AhmedAdelKhalilHamza/NEON_2x1M/IDC_8Pin.png

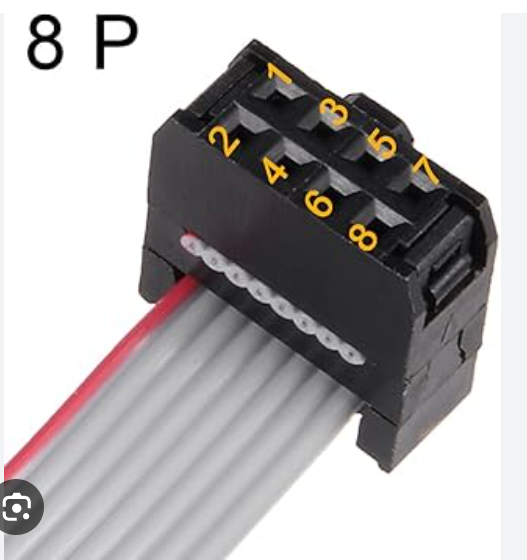
IDC_8Pin.png
