AhmedAdelKhalilHamza/NEON_2x1M/tutankhamon.png

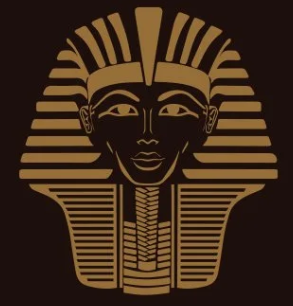
tutankhamon.png
