AhmedAdelKhalilHamza/NEON_2x1M/buck_converter_XL1509-3.3E1.png

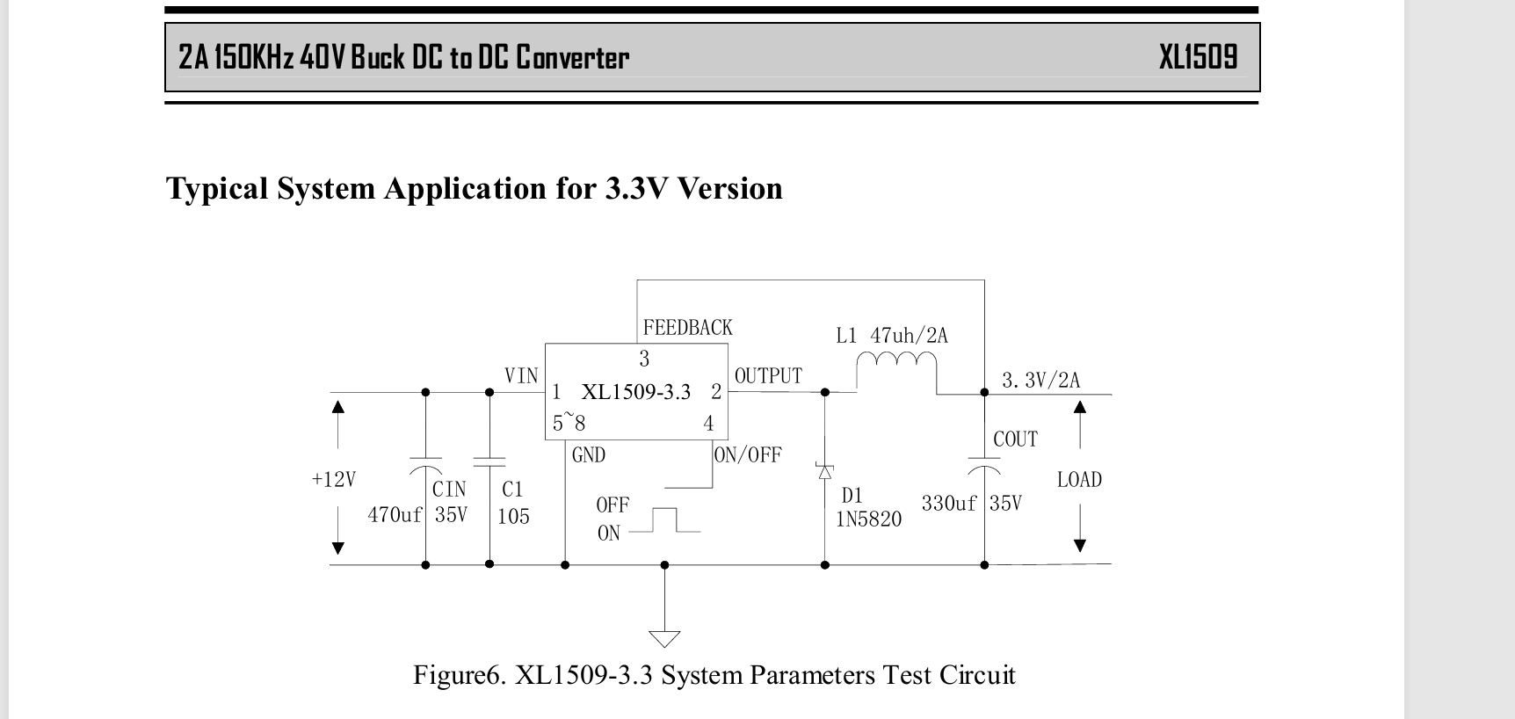
buck_converter_XL1509-3.3E1.png
