AhmedAdelKhalilHamza/NEON_2x1M/Neon_2x1M_12V/components_checklist_Neon_2x1M_12V.xlsx

Reference | Qty | Value | DNP | Exclude from BOM | Exclude from Board | Footprint | purchased components | link
C1 | 1 | 1 uF |  |  |  | Capacitor_SMD:C_1206_3216Metric | done | https://uge-one.com/product/smd-chip-capacitor-size-1206-1uf/
C2 | 1 | 470uF 35V |  |  |  | Capacitor_THT:CP_Radial_D10.0mm_P5.00mm |  | https://www.ram-e-shop.com/ar/shop/c-470u50v-capacitor-mkthf-kymyyy-470uf-mykrw-frd-50v-fwlt-6096
C3 | 1 | 330uF 50V |  |  |  | Capacitor_SMD:CP_Elec_10x10.5 | done | https://uge-one.com/product/smd-aluminum-electrolytic-capacitor-330uf-50v-1010-5-mm/
D1 | 1 | 1N5822 |  |  |  | Diode_SMD:D_SMA | done | https://uge-one.com/product/smd-schottky-diode-3a-40v-1n5822-ss34-sma/
D5 | 1 | Blue LED |  |  |  | LED_SMD:LED_1206_3216Metric_Pad1.42x1.75mm_HandSolder | done | https://makerselectronics.com/product/smd-led-blue-1206/
D9 | 1 | Red Power LED |  |  |  | LED_SMD:LED_1206_3216Metric_Pad1.42x1.75mm_HandSolder | done | https://makerselectronics.com/product/smd-led-red-1206/
D11 | 1 | LED_BGAR |  |  |  | LED_THT:LED_D5.0mm-4_RGB | done | https://makerselectronics.com/product/rgb-diffused-led-common-anode-5mm/
J2,J4,J5 | 3 | Barrel_Jack_MountingPin |  |  |  | Connector_BarrelJack:BarrelJack_Horizontal | done
J6 | 1 | Conn_01x03_Pin |  |  |  | Connector_PinHeader_2.54mm:PinHeader_1x03_P2.54mm_Vertical | done | https://microohm-eg.com/product/jst-3-pin-90-degree-male-connector/
L1 | 1 | 47uH / 2A |  |  |  | CD43_Inductor:CD43 | done | https://uge-one.com/product/smd-power-inductor-470uh-4-5x4x3-2mm-cd43/
Q1,Q2 | 2 | IRLML2502TRPBF |  |  |  | custom_SOT23:custom_SOT23 | 7 | https://uge-one.com/product/smd-irlml2502trpbf-sot-23-mosfet/
Q3 | 1 | Si2302DS |  |  |  | custom_SOT23:custom_SOT23 | 8 | https://uge-one.com/product/si2302ds-sot23-general-purpose-n-channel-mosfet-smd-transistor-sot-23/
Q4,Q5 | 2 | Si2302DS |  |  |  | Package_TO_SOT_SMD:SOT-23 | 9 | https://uge-one.com/product/si2302ds-sot23-general-purpose-n-channel-mosfet-smd-transistor-sot-23/
R1 | 1 | 820 Ohm |  |  |  | Resistor_SMD:R_1206_3216Metric_Pad1.30x1.75mm_HandSolder | 6 | https://uge-one.com/product/smd-chip-resistor-size-1206-820r-ohm/
R2,R5 | 2 | 100 Ohm |  |  |  | Resistor_SMD:R_1206_3216Metric_Pad1.30x1.75mm_HandSolder | 5 | https://uge-one.com/product/smd-chip-resistor-size-1206-100r-ohm/
R3,R6,R7,R8,R16,R17,R18 | 7 | 10k Ohm |  |  |  | Resistor_SMD:R_0805_2012Metric_Pad1.20x1.40mm_HandSolder | done | https://uge-one.com/product/0805-smd-chip-resistor-10k/
R4 | 1 | 820 Ohm |  |  |  | Resistor_SMD:R_1206_3216Metric_Pad1.30x1.75mm_HandSolder | 4 | https://uge-one.com/product/smd-chip-resistor-size-1206-820r-ohm/
R9,R14,R15,R19 | 4 | 300 Ohm |  |  |  | Resistor_SMD:R_1206_3216Metric_Pad1.30x1.75mm_HandSolder | 3 | https://uge-one.com/product/smd-chip-resistor-size-1206-300r-ohm/
R10,R11,R12 | 3 | 220 Ohm |  |  |  | Resistor_SMD:R_1206_3216Metric_Pad1.30x1.75mm_HandSolder | 2 | https://uge-one.com/product/smd-chip-resistor-size-1206-220r-ohm/
R13 | 1 | 680 Ohm |  |  |  | Resistor_SMD:R_1206_3216Metric_Pad1.30x1.75mm_HandSolder | 1 | https://uge-one.com/product/smd-chip-resistor-size-1206-680r-ohm/
SW1,SW2 | 2 | SW_Push |  |  |  | TS_button_3_4_2:TS_button_3_4_2 | done | https://uge-one.com/product/smd-micro-push-button-switch-2p-3x4x2mm/
U1 | 1 | ESP32-WROOM-32 |  |  |  | RF_Module:ESP32-WROOM-32 | done | https://uge-one.com/product/espressif-esp32-wroom-32-dual-core-wi-fi-bluetooth-iot-module/
U2 | 1 | XL1509-3.3 |  |  |  | Package_SO:SOIC-8_3.9x4.9mm_P1.27mm | done | https://uge-one.com/product/xl1509-3-3e1-2a-150khz-buck-dc-dc-step-down-converter-regulator-ic-smd/
