AhmedAdelKhalilHamza/NEON_2x1M/Neon_2x1M_12V/Neon_2x1M_12V.kicad_pcb

## KiCad design Neon_2x1M_12V/Neon_2x1M_12V.kicad_pcb (2025-11-08)

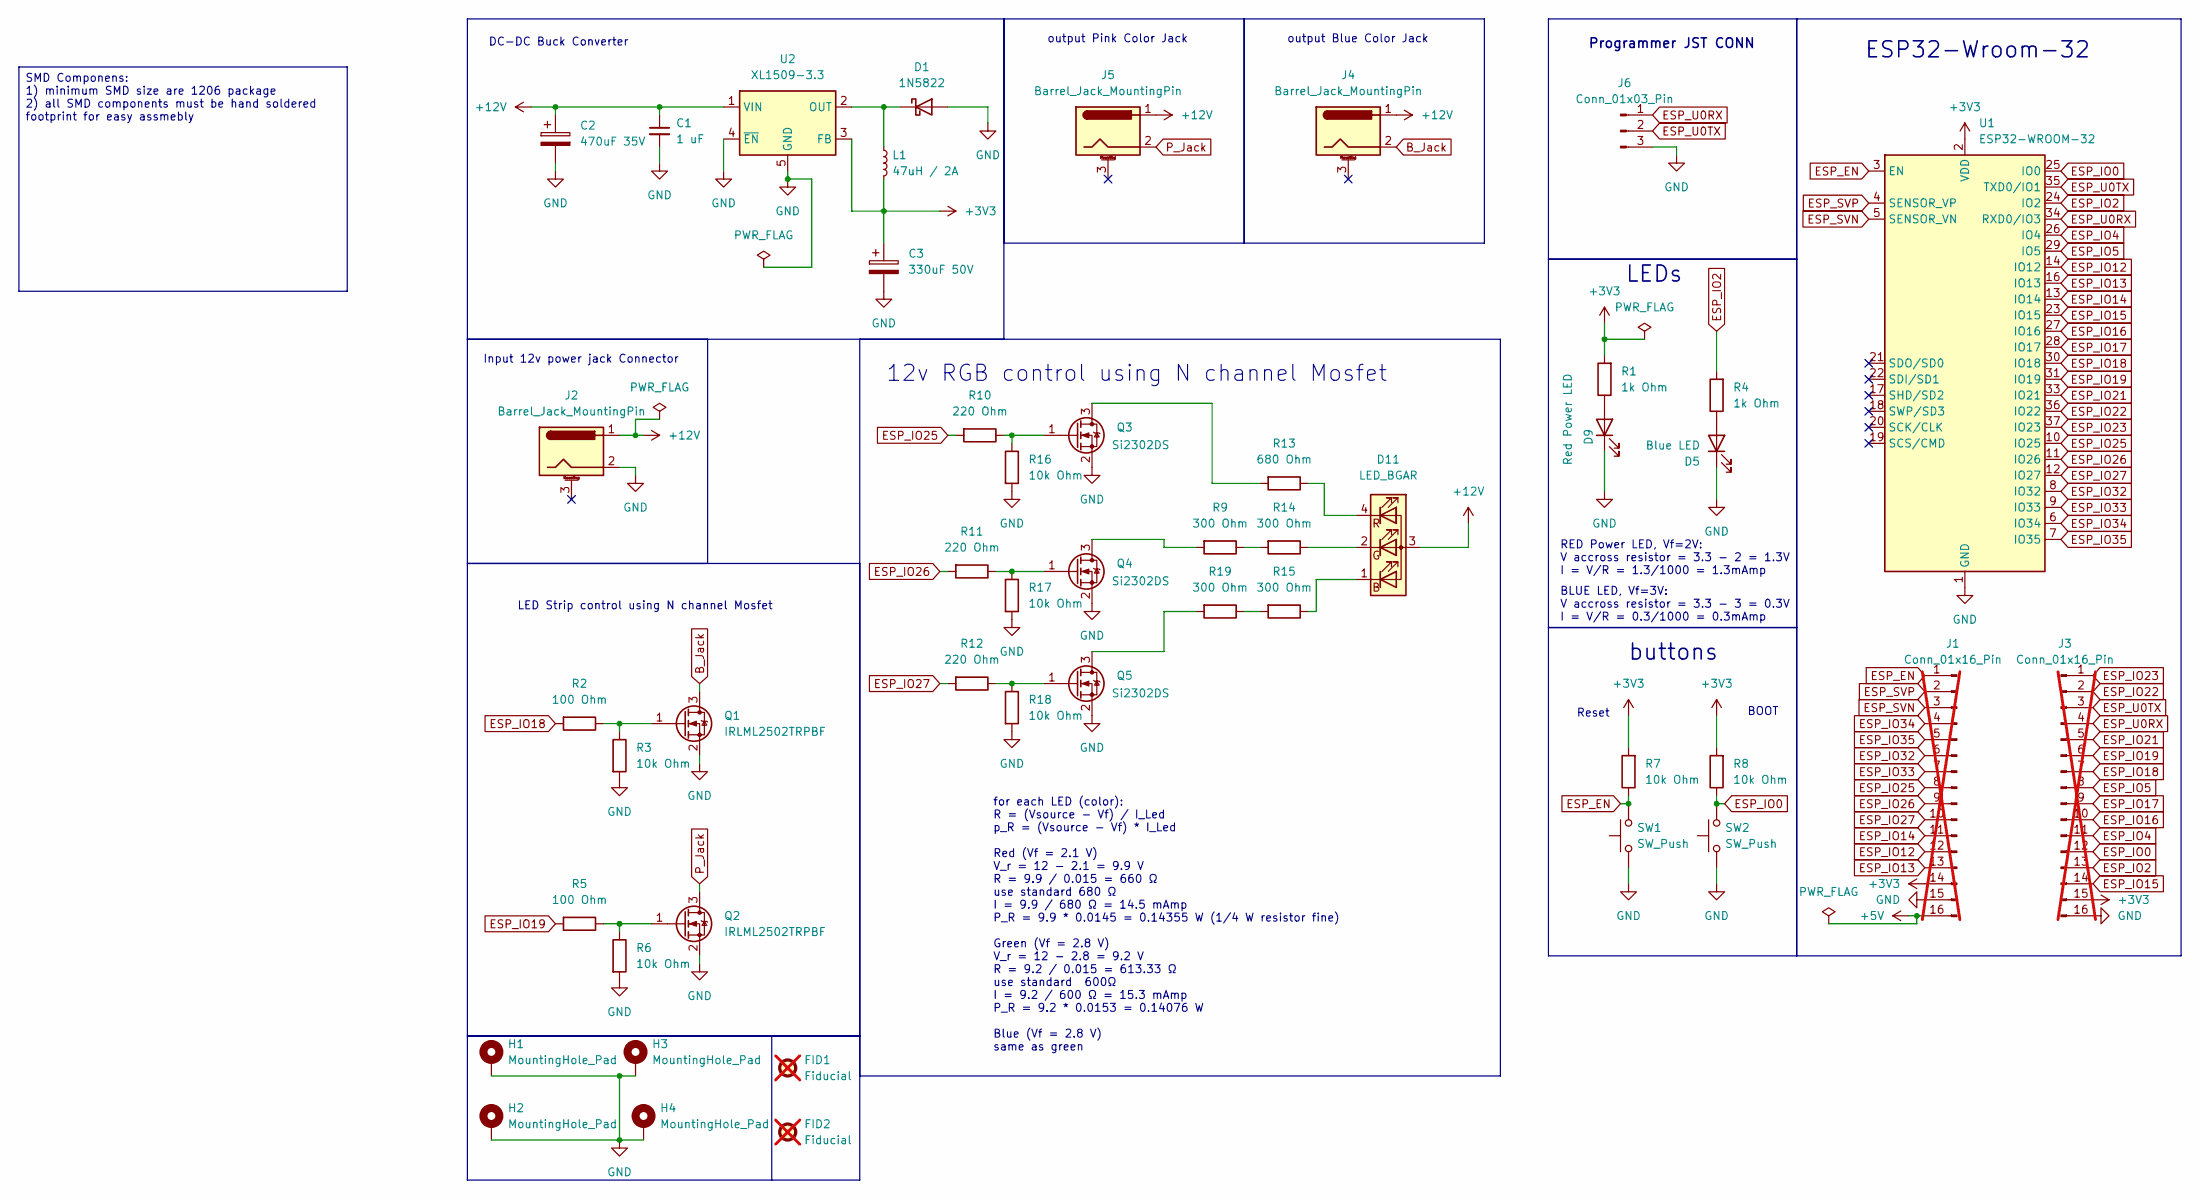
[picture p4: schematic Neon_2x1M_12V.kicad_sch, Neon 1meter 12V]

Parts:
C1: 1 uF; C_1206_3216Metric
C2: 470uF 35V; CP_Radial_D10.0mm_P5.00mm
C3: 330uF 50V; CP_Elec_10x10.5
D1: 1N5822; D_SMA
D5: Blue LED; LED_1206_3216Metric_Pad1.42x1.75mm_HandSolder
D9: Red Power LED; LED_1206_3216Metric_Pad1.42x1.75mm_HandSolder
D11: LED_BGAR; LED_D5.0mm-4_RGB
FID1, FID2: Fiducial; Fiducial_0.5mm_Mask1.5mm; not fitted
H1, H2, H3, H4: MountingHole_Pad; MountingHole_3.2mm_M3_Pad_Via
J1, J3: Conn_01x16_Pin; PinHeader_1x16_P2.54mm_Vertical; not fitted
J2, J4, J5: Barrel_Jack_MountingPin; BarrelJack_Horizontal
J6: Conn_01x03_Pin; PinHeader_1x03_P2.54mm_Vertical
L1: 47uH / 2A; CD43
Q1, Q2: IRLML2502TRPBF; custom_SOT23
Q3: Si2302DS; custom_SOT23
Q4, Q5: Si2302DS; SOT-23
R1, R4: 1k Ohm; R_1206_3216Metric_Pad1.30x1.75mm_HandSolder
R2, R5: 100 Ohm; R_1206_3216Metric_Pad1.30x1.75mm_HandSolder
R3, R6, R7, R8, R16, R17, R18: 10k Ohm; R_0805_2012Metric_Pad1.20x1.40mm_HandSolder
R9, R14, R15, R19: 300 Ohm; R_1206_3216Metric_Pad1.30x1.75mm_HandSolder
R10, R11, R12: 220 Ohm; R_1206_3216Metric_Pad1.30x1.75mm_HandSolder
R13: 680 Ohm; R_1206_3216Metric_Pad1.30x1.75mm_HandSolder
SW1, SW2: SW_Push; TS_button_3_4_2
U1: ESP32-WROOM-32
U2: XL1509-3.3; SOIC-8_3.9x4.9mm_P1.27mm

Connections:
+3V3: C3.1, J1.14, J3.15, L1.2, R1.2, R7.2, R8.2, U1.2 (VDD), U2.3 (FB)
+12V: C1.1, C2.1, D11.3 (A), J2.1, J4.1, J5.1, U2.1 (VIN)
B_Jack: J4.2, Q1.3 (D)
ESP_EN: J1.1, R7.1, SW1.2, U1.3 (EN)
ESP_IO0: J3.12, R8.1, SW2.2, U1.25 (IO0)
ESP_IO2: J3.13, R4.2, U1.24 (IO2)
ESP_IO4: J3.11, U1.26 (IO4)
ESP_IO5: J3.8, U1.29 (IO5)
ESP_IO12: J1.12, U1.14 (IO12)
ESP_IO13: J1.13, U1.16 (IO13)
ESP_IO14: J1.11, U1.13 (IO14)
ESP_IO15: J3.14, U1.23 (IO15)
ESP_IO16: J3.10, U1.27 (IO16)
ESP_IO17: J3.9, U1.28 (IO17)
ESP_IO18: J3.7, R2.2, U1.30 (IO18)
ESP_IO19: J3.6, R5.2, U1.31 (IO19)
ESP_IO21: J3.5, U1.33 (IO21)
ESP_IO22: J3.2, U1.36 (IO22)
ESP_IO23: J3.1, U1.37 (IO23)
ESP_IO25: J1.8, R10.2, U1.10 (IO25)
ESP_IO26: J1.9, R11.2, U1.11 (IO26)
ESP_IO27: J1.10, R12.2, U1.12 (IO27)
ESP_IO32: J1.6, U1.8 (IO32)
ESP_IO33: J1.7, U1.9 (IO33)
ESP_IO34: J1.4, U1.6 (IO34)
ESP_IO35: J1.5, U1.7 (IO35)
ESP_SVN: J1.3, U1.5 (SENSOR_VN)
ESP_SVP: J1.2, U1.4 (SENSOR_VP)
ESP_U0RX: J3.4, J6.1, U1.34 (RXD0/IO3)
ESP_U0TX: J3.3, J6.2, U1.35 (TXD0/IO1)
GND: C1.2, C2.2, C3.2, D1.2 (A), D5.1 (K), D9.1 (K), H1.1, H2.1, H3.1, H4.1, J1.15, J2.2, J3.16, J6.3, Q1.2 (S), Q2.2 (S), Q3.2 (S), Q4.2 (S), Q5.2 (S), R3.2, R6.2, R16.2, R17.2, R18.2, SW1.1, SW2.1, U1.1 (GND), U1.15 (GND), U1.38 (GND), U1.39 (GND), U2.4 (~EN), U2.5 (GND), U2.6 (GND), U2.7 (GND), U2.8 (GND)
unnamed: D1.1 (K), L1.1, U2.2 (OUT)
unnamed: D5.2 (A), R4.1
unnamed: D9.2 (A), R1.1
unnamed: D11.1 (BK), R15.1
unnamed: D11.2 (GK), R14.1
unnamed: D11.4 (RK), R13.1
unnamed: Q1.1 (G), R2.1, R3.1
unnamed: Q2.1 (G), R5.1, R6.1
unnamed: Q3.3 (D), R13.2
unnamed: Q3.1 (G), R10.1, R16.1
unnamed: Q4.3 (D), R9.2
unnamed: Q4.1 (G), R11.1, R17.1
unnamed: Q5.3 (D), R19.2
unnamed: Q5.1 (G), R12.1, R18.1
unnamed: R9.1, R14.2
unnamed: R15.2, R19.1
P_Jack: J5.2, Q2.3 (D)

Notes on the sheet:
ESP32-Wroom-32
LED Strip control using N channel Mosfet
DC-DC Buck Converter
buttons
output Pink Color Jack
RED Power LED, Vf=2V: V accross resistor = 3.3 - 2 = 1.3V I = V/R = 1.3/1000 = 1.3mAmp
Input 12v power jack Connector
for each LED (color): R = (Vsource - Vf) / I_Led p_R = (Vsource - Vf) * I_Led Red (Vf = 2.1 V) V_r = 12 − 2.1 = 9.9 V R = 9.9 / 0.015 = 660 Ω use standard 680 Ω I = 9.9 / 680 Ω = 14.5 mAmp P_R = 9.9 * 0.0145 = 0.14355 W (1/4 W resistor fine) Green (Vf = 2.8 V) V_r = 12 − 2.8 = 9.2 V R = 9.2 / 0.015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
12v RGB control using N channel Mosfet
Reset
BLUE LED, Vf=3V: V accross resistor = 3.3 - 3 = 0.3V I = V/R = 0.3/1000 = 0.3mAmp
LEDs
BOOT
output Blue Color Jack
Programmer JST CONN
SMD Componens: 1) minimum SMD size are 1206 package 2) all SMD components must be hand soldered footprint for easy assmebly

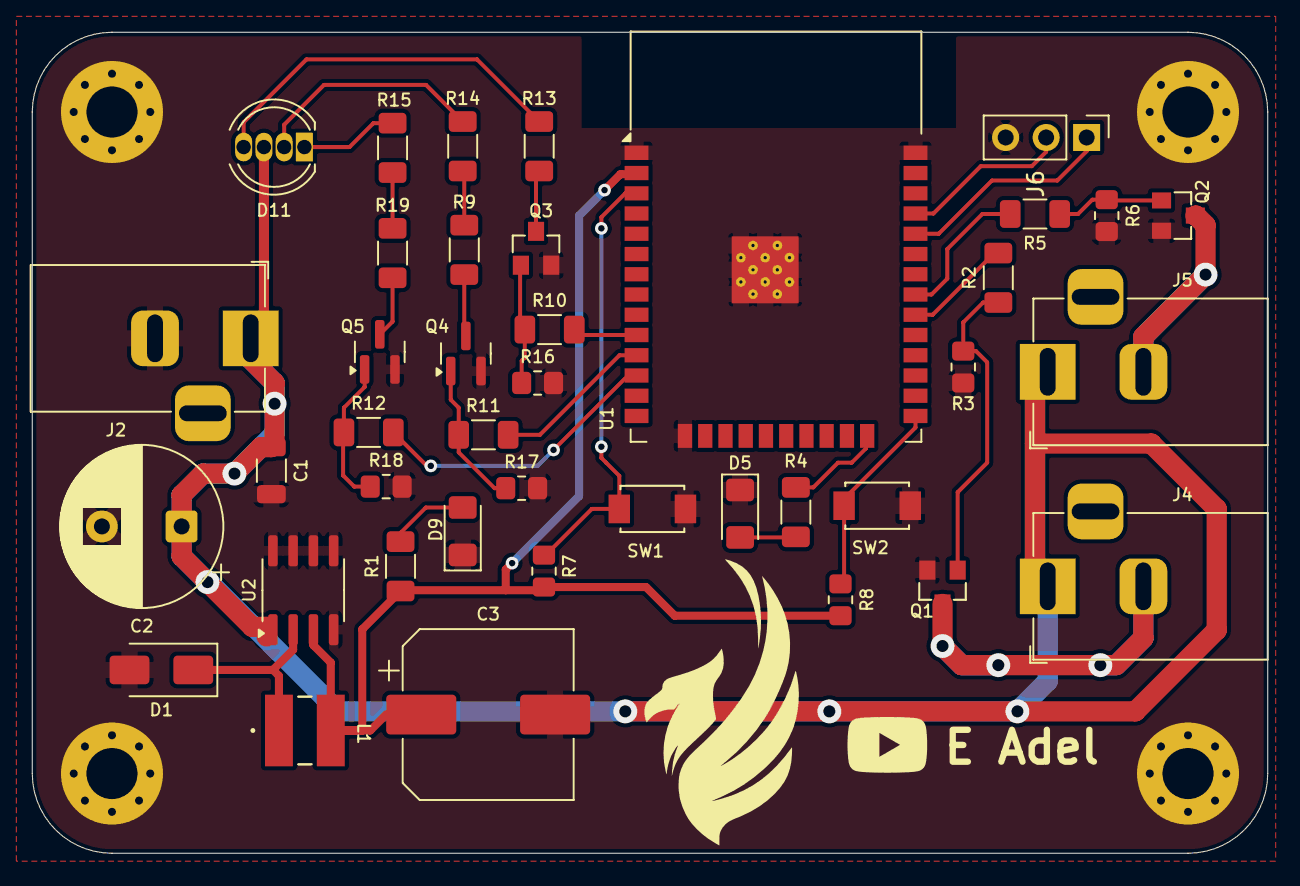
[picture p5: board Neon_2x1M_12V.kicad_pcb from above]

Board: 2 copper layers, 77.5 x 51.5 mm, 44 parts (0 on the bottom side), 31 nets.
