AhmedAdelKhalilHamza/NEON_2x1M/(commit log)

2025-10-31 added dc-dc buck converter to schematic
    [Neon_5meter_12V.kicad_pcb, Neon_5meter_12V.kicad_sch]
2025-11-02 updated schematic
    [Neon_5meter_12V.kicad_sch]
2025-11-02 added external JST programmer connector
    [Neon_5meter_12V.kicad_sch]
2025-11-03 updated BOM
    [Neon_5meter_12V.kicad_sch]
2025-11-04 updated component placement
    [Neon_5meter_12V.kicad_pcb, Neon_5meter_12V.kicad_sch]
2025-11-04 updated 1x3 pin header jst connector footprint
    [Neon_5meter_12V.kicad_pcb, Neon_5meter_12V.kicad_sch]
2025-11-06 updated placement removed pinheaders
    [Neon_5meter_12V.kicad_pcb, Neon_5meter_12V.kicad_sch]
2025-11-06 updated logos and added pharohs logo
    [Neon_5meter_12V.kicad_pcb]
2025-11-06 update mounting holes placement
    [Neon_5meter_12V.kicad_pcb]
2025-11-06 fast routing
    [Neon_5meter_12V.kicad_pcb]
2025-11-06 updated tutankhamon logo
    [Neon_5meter_12V.kicad_pcb, Neon_5meter_12V.kicad_sch]
2025-11-06 updated routing and tutankhamon place on b.silkscreen
    [Neon_5meter_12V.kicad_pcb]
2025-11-07 chnaged some of sot23 to be custom footprint to see which is better in hand soldering
    [Neon_5meter_12V.kicad_pcb, Neon_5meter_12V.kicad_sch]
2025-11-08 updated output jack routing
    [Neon_2x1M_12V.kicad_pcb]
2025-11-08 updated JST PIN header placement
    [Neon_2x1M_12V.kicad_pcb]
2025-11-08 fixed some vias diameters
    [Neon_2x1M_12V.kicad_pcb]
2025-11-08 updatd components checklist
    [components_checklist_Neon_2x1M_12V.csv, components_checklist_Neon_2x1M_12V.xlsx]
2025-11-08 update BOM only 1k resistor is needed
    [Neon_2x1M_12V.csv, Neon_2x1M_12V.kicad_sch, components_checklist_Neon_2x1M_12V.xlsx]
2025-11-09 removed blue led and replaced it with red one and also updated their current imiting resistor
    [Neon_2x1M_12V.kicad_sch, components_checklist_Neon_2x1M_12V.xlsx]
